FurtherV/SensorCube/AirCube/aircube.kicad_pcb

## KiCad design AirCube/aircube.kicad_pcb (2026-07-11)

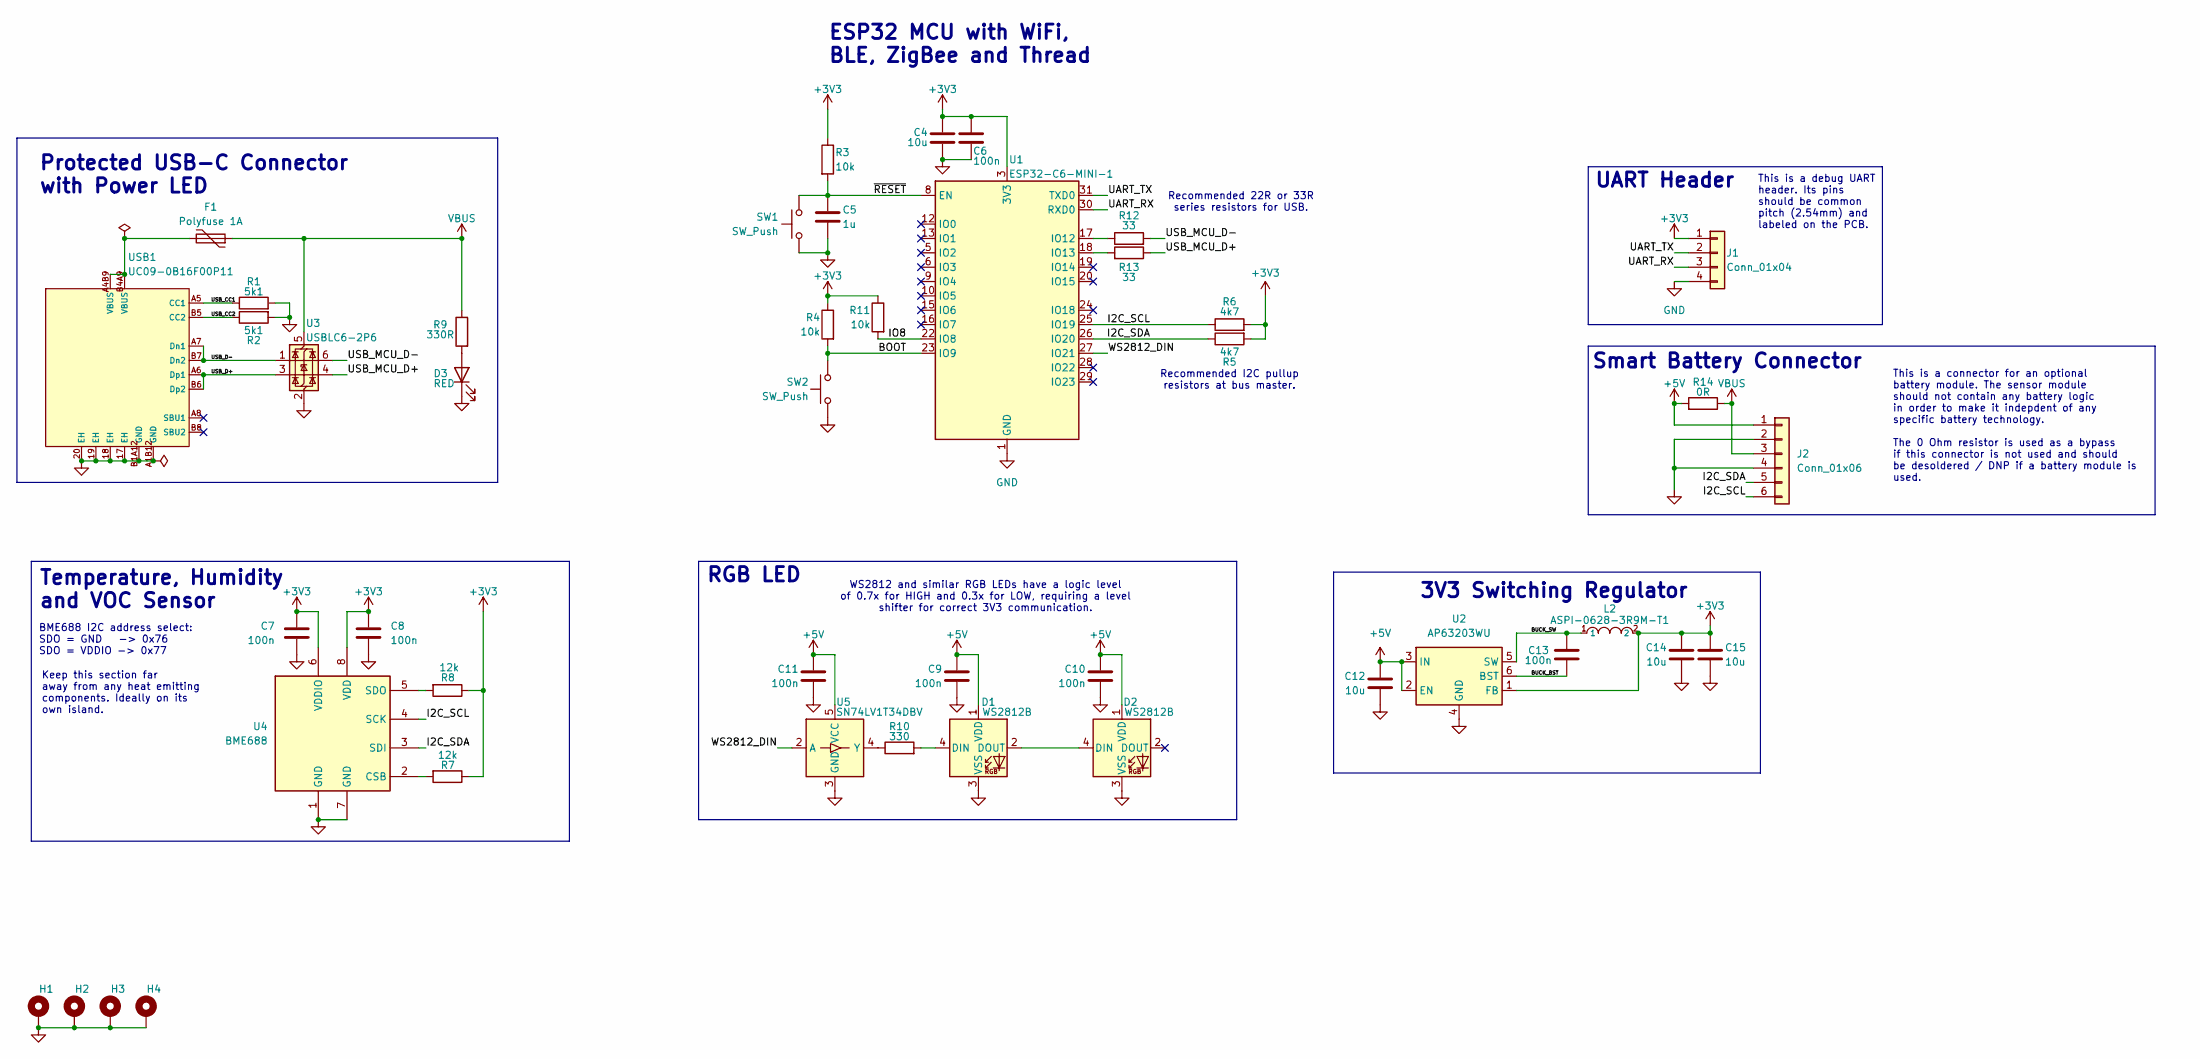
[picture p1: schematic aircube.kicad_sch]

Parts:
C4: 10u; C_0603_1608Metric
C5: 1u; C_0603_1608Metric
C6, C7, C8, C9, C10, C11, C13: 100n; C_0603_1608Metric
C12, C14, C15: 10u; C_0805_2012Metric
D1, D2: WS2812B; LED_WS2812B_PLCC4_5.0x5.0mm_P3.2mm
D3: RED; LED_0603_1608Metric
F1: Polyfuse 1A; Fuse_1812_4532Metric
H1, H2, H3, H4: MountingHole_Pad; MountingHole_2.2mm_M2_Pad
J1: Conn_01x04; PinHeader_1x04_P2.54mm_Vertical
J2: Conn_01x06; JST_PH_B6B-PH-K_1x06_P2.00mm_Vertical
L2: ASPI-0628-3R9M-T1; C5570229_IND-SMD_L6_0-W6_0; LCSC C5570229
R1, R2: 5k1; R_0603_1608Metric
R3, R4, R11: 10k; R_0603_1608Metric
R5, R6: 4k7; R_0603_1608Metric
R7, R8: 12k; R_0603_1608Metric
R9: 330R; R_0603_1608Metric
R10: 330; R_0603_1608Metric
R12, R13: 33; R_0603_1608Metric
R14: 0R; R_0805_2012Metric_Pad1.20x1.40mm_HandSolder
SW1, SW2: SW_Push
U1: ESP32-C6-MINI-1
U2: AP63203WU; TSOT-23-6
U3: USBLC6-2P6; SOT-666
U4: BME688; Bosch_LGA-8_3x3mm_P0.8mm_ClockwisePinNumbering
U5: SN74LV1T34DBV; SOT-23-5
USB1: UC09-0B16F00P11; C36936538_USB-C_UC09-0B16F00P11; LCSC C36936538

Connections:
+3V3: C4.1, C6.1, C7.1, C8.1, C14.1, C15.1, J1.1, L2.2, R3.1, R4.1, R5.2, R6.2, R7.1, R8.1, R11.1, U1.3 (3V3), U2.1 (FB), U4.6 (VDDIO), U4.8 (VDD)
+5V: C9.1, C10.1, C11.1, C12.1, D1.1 (VDD), D2.1 (VDD), J2.1, R14.2, U2.2 (EN), U2.3 (IN), U5.5 (VCC)
/BOOT: R4.2, SW2.1, U1.23 (IO9)
/BUCK_BST: C13.1, U2.6 (BST)
/BUCK_SW: C13.2, L2.1, U2.5 (SW)
/I2C_SCL: J2.6, R6.1, U1.25 (IO19), U4.4 (SCK)
/I2C_SDA: J2.5, R5.1, U1.26 (IO20), U4.3 (SDI)
/IO8: R11.2, U1.22 (IO8)
/UART_RX: J1.3, U1.30 (RXD0)
/UART_TX: J1.2, U1.31 (TXD0)
/USB_CC1: R1.1, USB1.A5 (CC1)
/USB_CC2: R2.1, USB1.B5 (CC2)
/USB_D+: U3.3 (I/O2), USB1.A6 (Dp1), USB1.B6 (Dp2)
/USB_D-: U3.1 (I/O1), USB1.A7 (Dn1), USB1.B7 (Dn2)
/USB_MCU_D+: R13.1, U3.4 (I/O2)
/USB_MCU_D-: R12.2, U3.6 (I/O1)
/WS2812_DIN: U1.27 (IO21), U5.2 (A)
/~RESET: C5.1, R3.2, SW1.1, U1.8 (EN)
GND: C4.2, C5.2, C6.2, C7.2, C8.2, C9.2, C10.2, C11.2, C12.2, C14.2, C15.2, D1.3 (VSS), D2.3 (VSS), D3.1 (K), H1.1 (1_1), H2.1 (1_1), H3.1 (1_1), H4.1 (1_1), J1.4, J2.2, J2.4, R1.2, R2.2, SW1.2, SW2.2, U1.1 (GND), U1.2 (GND), U1.11 (GND), U1.14 (GND), U1.36 (GND), U1.37 (GND), U1.38 (GND), U1.39 (GND), U1.40 (GND), U1.41 (GND), U1.42 (GND), U1.43 (GND), U1.44 (GND), U1.45 (GND), U1.46 (GND), U1.47 (GND), U1.48 (GND), U1.49 (GND), U1.50 (GND), U1.51 (GND), U1.52 (GND), U1.53 (GND), U2.4 (GND), U3.2 (GND), U4.1 (GND), U4.7 (GND), U5.3 (GND), USB1.17 (EH), USB1.18 (EH), USB1.19 (EH), USB1.20 (EH), USB1.A1B12 (GND), USB1.B1A12 (GND)
unnamed: D1.4 (DIN), R10.2
unnamed: D1.2 (DOUT), D2.4 (DIN)
unnamed: D3.2 (A), R9.2
unnamed: F1.2, USB1.A4B9 (VBUS), USB1.B4A9 (VBUS)
unnamed: R12.1, U1.17 (IO12)
unnamed: R13.2, U1.18 (IO13)
unnamed: R7.2, U4.2 (CSB)
unnamed: R8.2, U4.5 (SDO)
unnamed: R10.1, U5.4 (Y)
VBUS: F1.1, J2.3, R9.1, R14.1, U3.5 (VBUS)

Notes on the sheet:
Smart Battery Connector
3V3 Switching Regulator
This is a connector for an optional battery module. The sensor module should not contain any battery logic in order to make it indepdent of any specific battery technology. The 0 Ohm resistor is used as a bypass if this connector is not used and should be desoldered / DNP if a battery module is use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
Recommended I2C pullup resistors at bus master.
WS2812 and similar RGB LEDs have a logic level of 0.7x for HIGH and 0.3x for LOW, requiring a level shifter for correct 3V3 communication.
Keep this section far away from any heat emitting components. Ideally on its own island.
Recommended 22R or 33R series resistors for USB.
Protected USB-C Connector with Power LED
Temperature, Humidity and VOC Sensor
ESP32 MCU with WiFi, BLE, ZigBee and Thread
RGB LED
BME688 I2C address select: SDO = GND -> 0x76 SDO = VDDIO -> 0x77
UART Header
This is a debug UART header. Its pins should be common pitch (2.54mm) and labeled on the PCB.

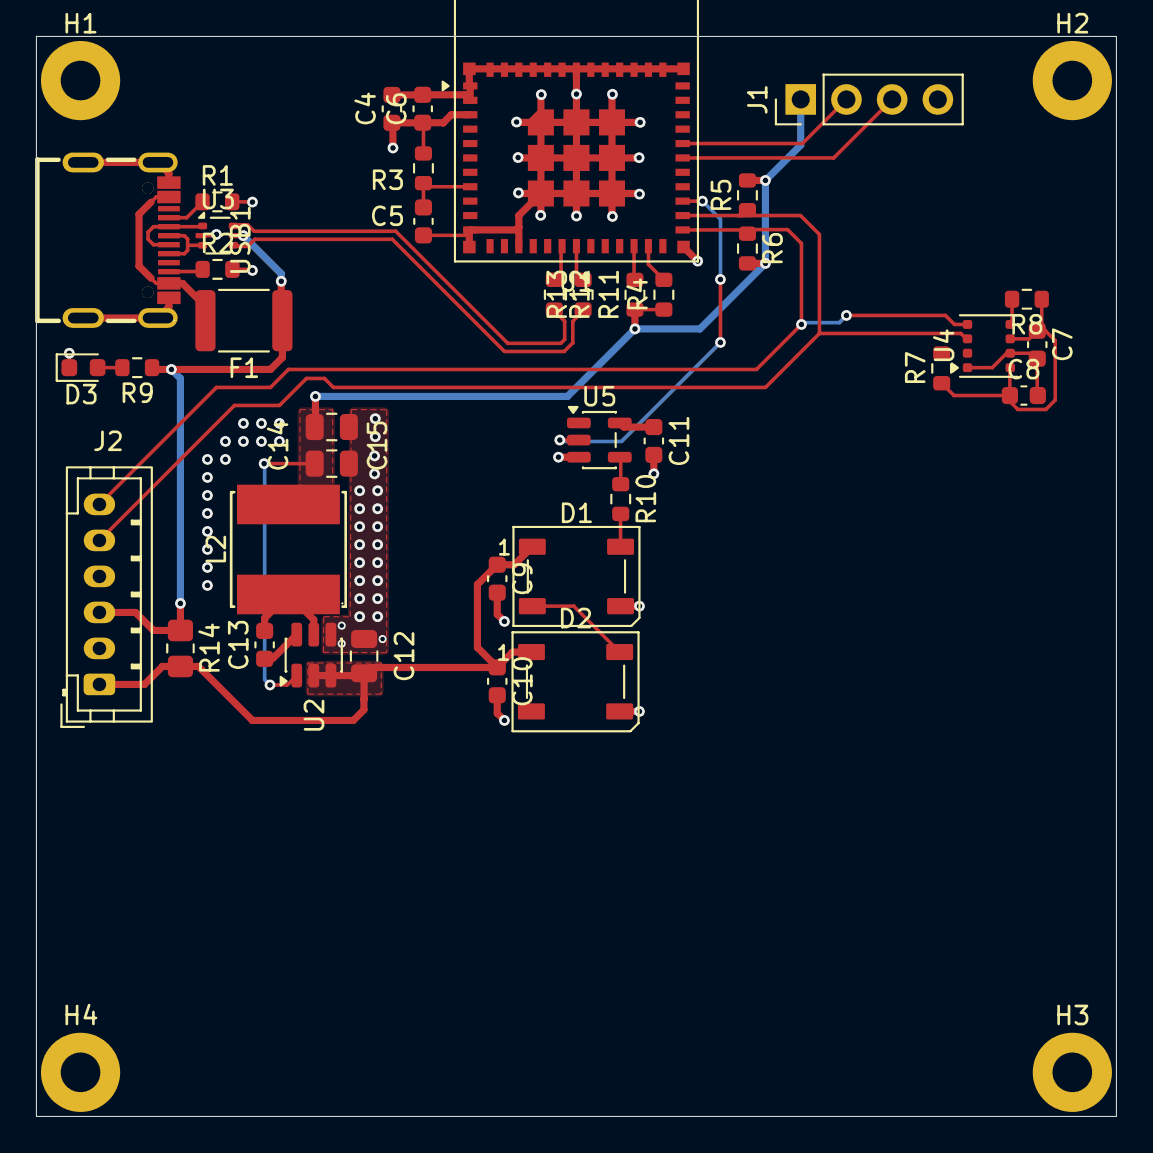
[picture p2: board aircube.kicad_pcb from above]

Board: 4 copper layers, 60.0 x 60.0 mm, 43 parts (0 on the bottom side), 29 nets.
